judapies/Scrubber/2018/Artilab/Schematic/Scrubber V01.DXF

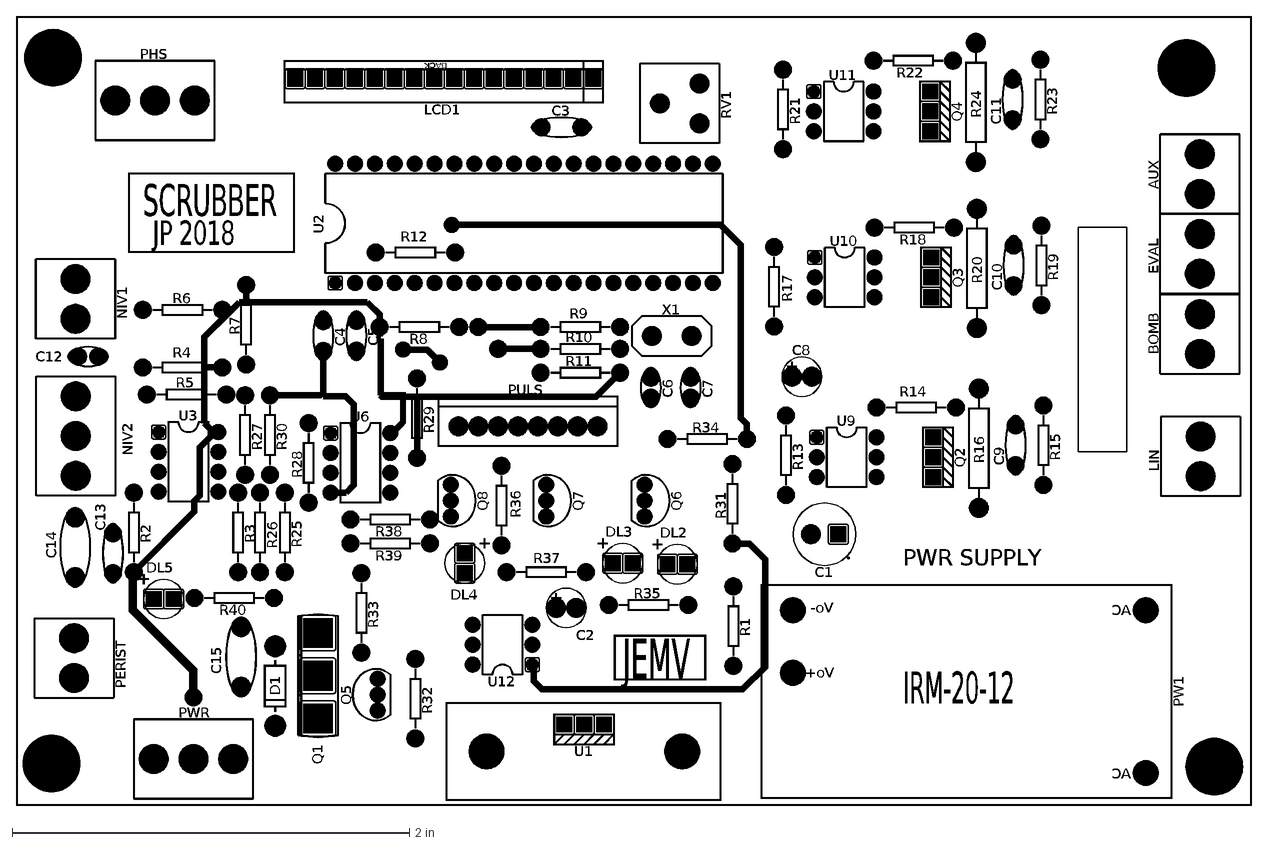
[picture p1: CAD file, 2021-07-30]
2018/Artilab/Schematic/Scrubber V01.DXF
U2
PHS
PULS
U9
Q2
BOMB
R13
R14
R16
C9
R15
U10
Q3
EVAL
R17
R18
R20
C10
R19
U11
Q4
AUX
R21
R22
R24
C11
R23
LIN
U3
U6
R12
PERIST
U12
Q5
Q1
R32
U1
C1
C2
AC
Vo+
Vo-
PW1
NIV2
RV1
BACK
LCD1
R8
R9
R10
R11
C4
C5
C3
C8
X1
C6
C7
R31
R1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
