judapies/Scrubber/2019/Bioweb/Schematic/Scrubber V01.DXF

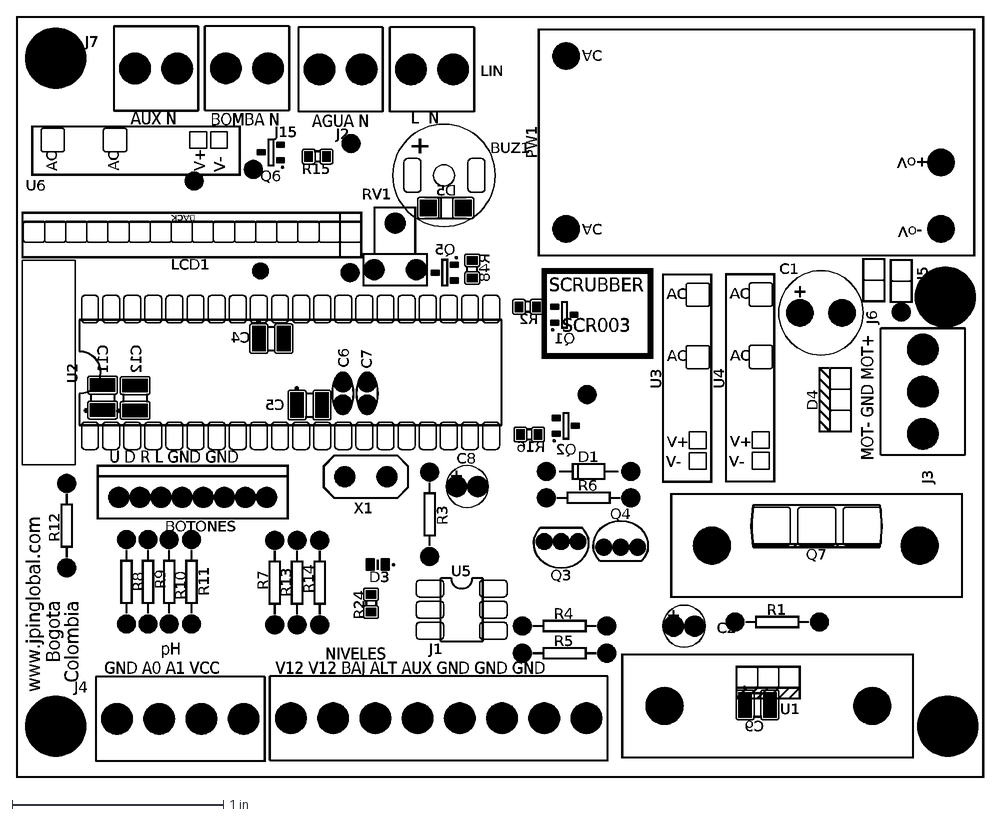
[picture p2: CAD file, 2021-07-30]
2019/Bioweb/Schematic/Scrubber V01.DXF
U1
AC
Vo+
Vo-
PW1
U2
R12
C12
C11
J4
R8
R9
R10
R11
R7
R13
R14
J1
BOTONES
R3
U5
X1
C6
C7
R4
R5
Q3
Q4
R6
D1
Q7
R16
Q2
V+
V-
U3
R2
Q1
U4
BACK
LCD1
J15
J3
J2
LIN
D4
R48
Q5
R24
D3
+
BUZ1
D5
R1
C4
C5
C8
C9
C1
C2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
