judapies/Scrubber/(list of files, cad)

Other CAD files:
2018/Artilab/Plano Electrico/Plano Electrico Scrubber/ConexionesElectricasYElectronicas.dwg
2019/Bioweb/Plano Electrico/Plano Electrico Scrubber/ConexionesElectricasYElectronicas.dwg
2021/Bioweb/Plano Electrico/Plano Electrico Scrubber/ConexionesElectricasYElectronicas.dwg
Plano Electrico/Mini-Cabina 110VAC/Distribucion de conexiones.dwg
Plano Electrico/Plano_Electrico_Cabina_Flujo_Vertical/Distribución de Conexiones.dwg
Plano Electrico/Plano_Electrico_Cabina_Flujo_Vertical/Conexiones de Luz Germicida y Luz Blanca.dwg
Plano Electrico/Plano_Electrico_Cabina_Flujo_Vertical/Conexiones de Panel de Control.dwg
Plano Electrico/Plano_Electrico_Cabina_Flujo_Vertical/Cabina_Flujo_Laminar_Vertical_JPCV36.dwg
