judapies/Scrubber/2018/Artilab/Plano Electrico/PlanoScrubberJEMV.pdf

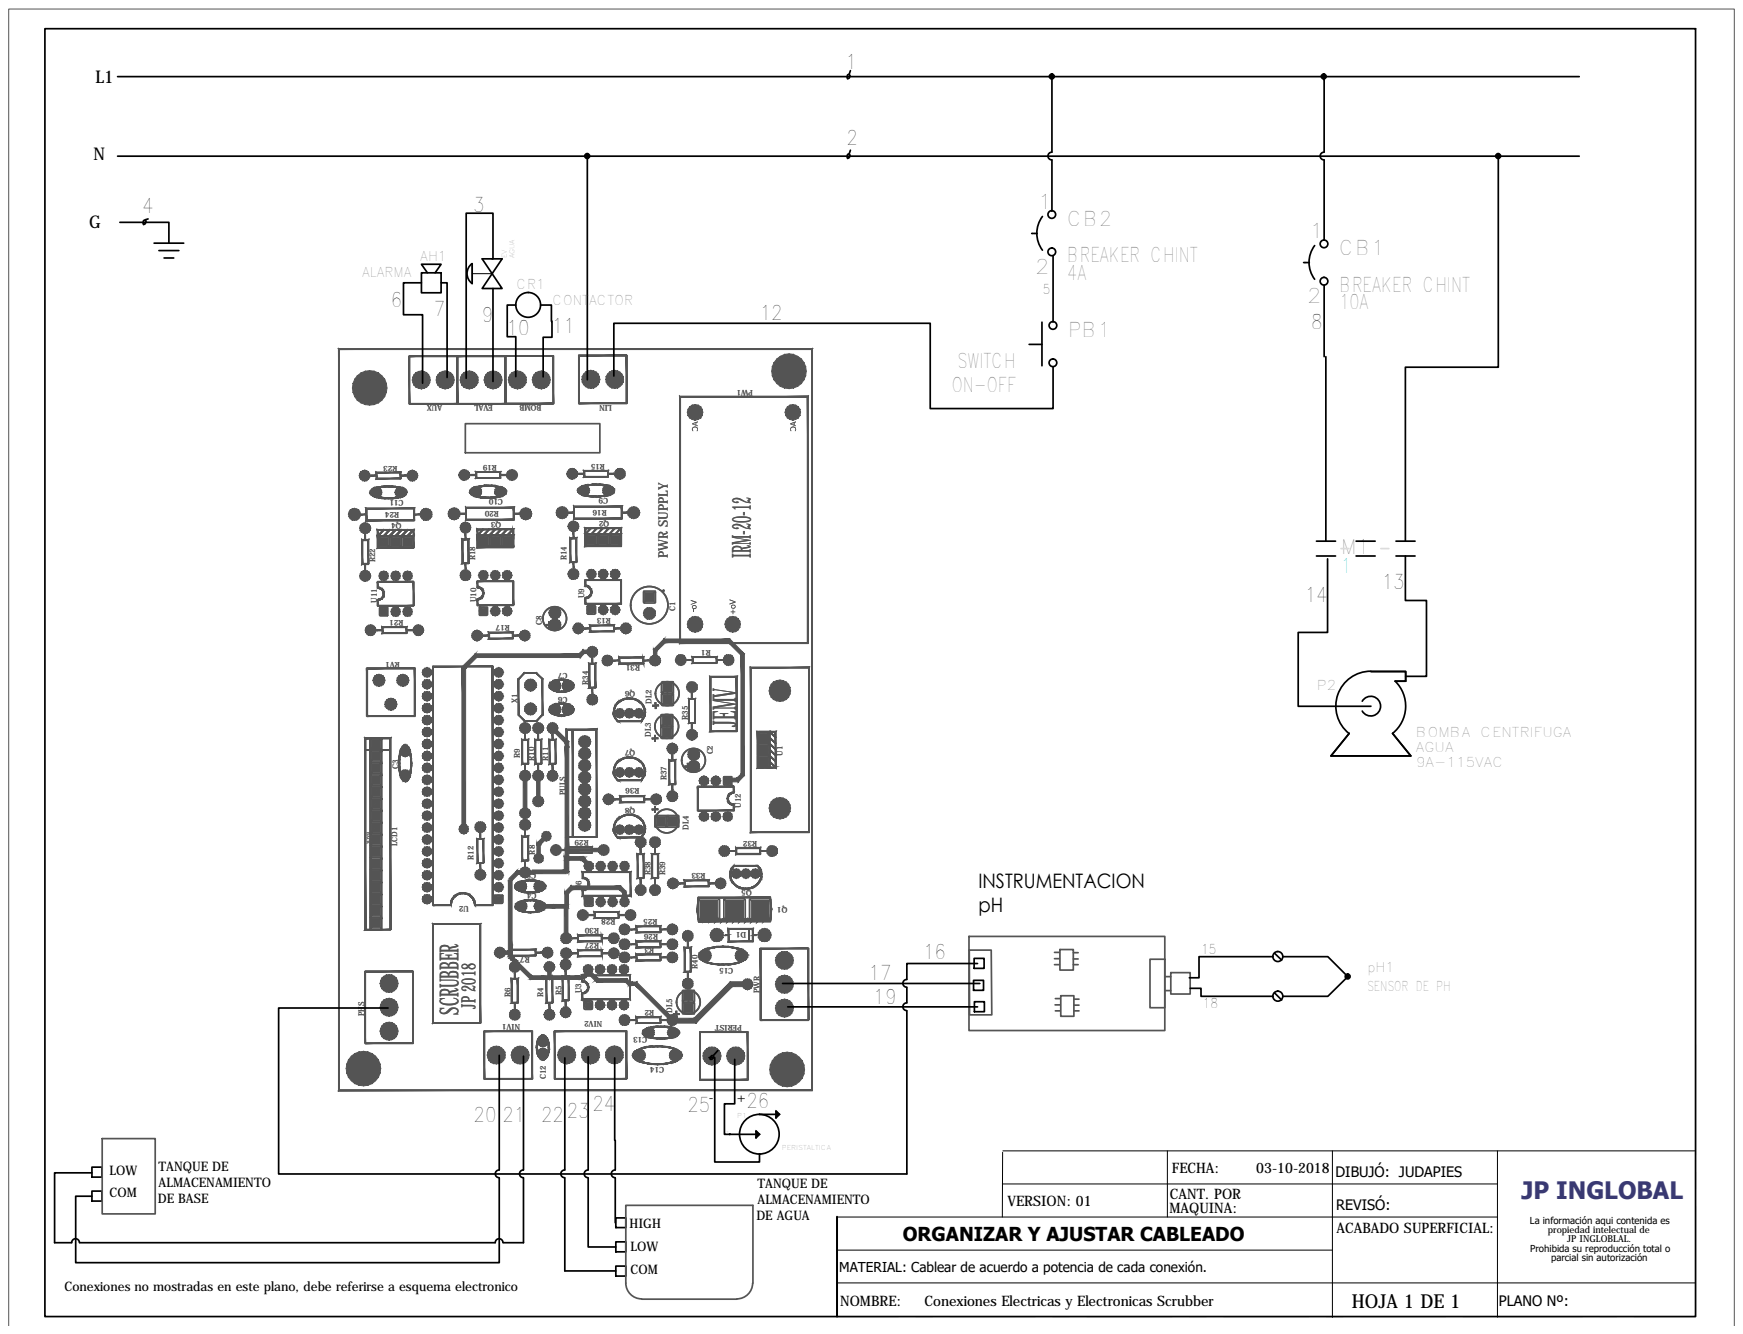
[picture p19: page 1]

AGUA ALARMA AH1 CONTACTOR CR1 BOMBA CENTRIFUGA AGUA 9A-115VAC P2 INSTRUMENTACION pH SENSOR DE PH pH1 3 5 8 9 14 1719 20 21 23 12 10 11 7 6 13 LOW COM 22 24 25 26 16 18 15

PWR D1 ON-OFF SWITCH PB1 4ABREAKER CHINT CB2 21 TANQUE DE ALMACENAMIENTO DE AGUA HIGH LOW COM TANQUE DE ALMACENAMIENTO DE BASE PERISTALTICA + - P1 - +
