judapies/Scrubber/2019/Bioweb/Plano Electrico/PlanoScrubber.pdf

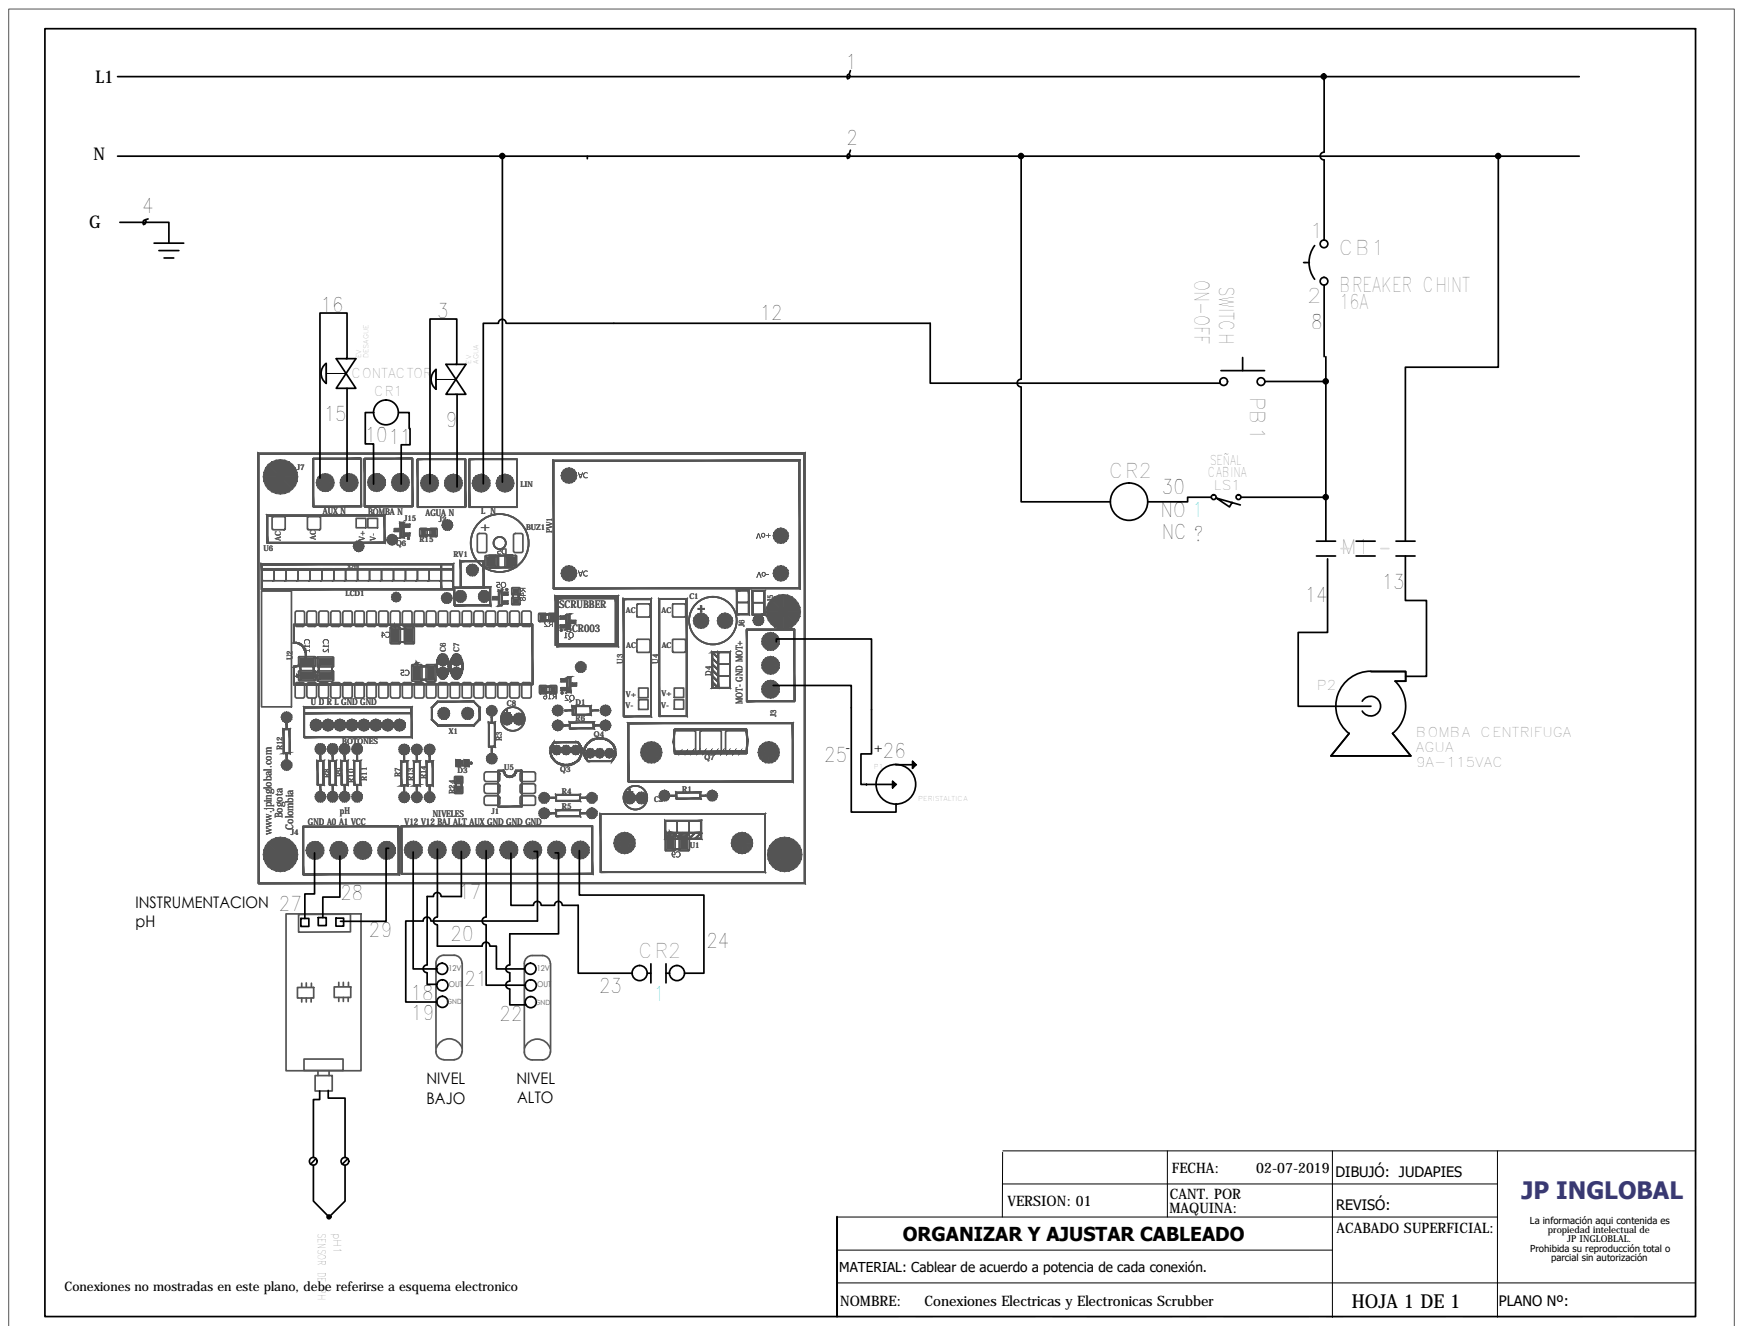
[picture p20: page 1]

J6 GND A0 A1 VCC pH V12 V12 BAJ ALT AUX GND GND GND NIVELES U D R L GND GND MOT- GND MOT+ BOMBA N AGUA N L N

pH1 PERISTALTICA + - P1 25- +26 12V GND OUT 12V GND OUT NIVEL BAJO NIVEL ALTO 1918 22 21 2017 23 24
