judapies/Scrubber/Plano Electrico/PDF/Distribución de Conexiones-Presentación1.pdf

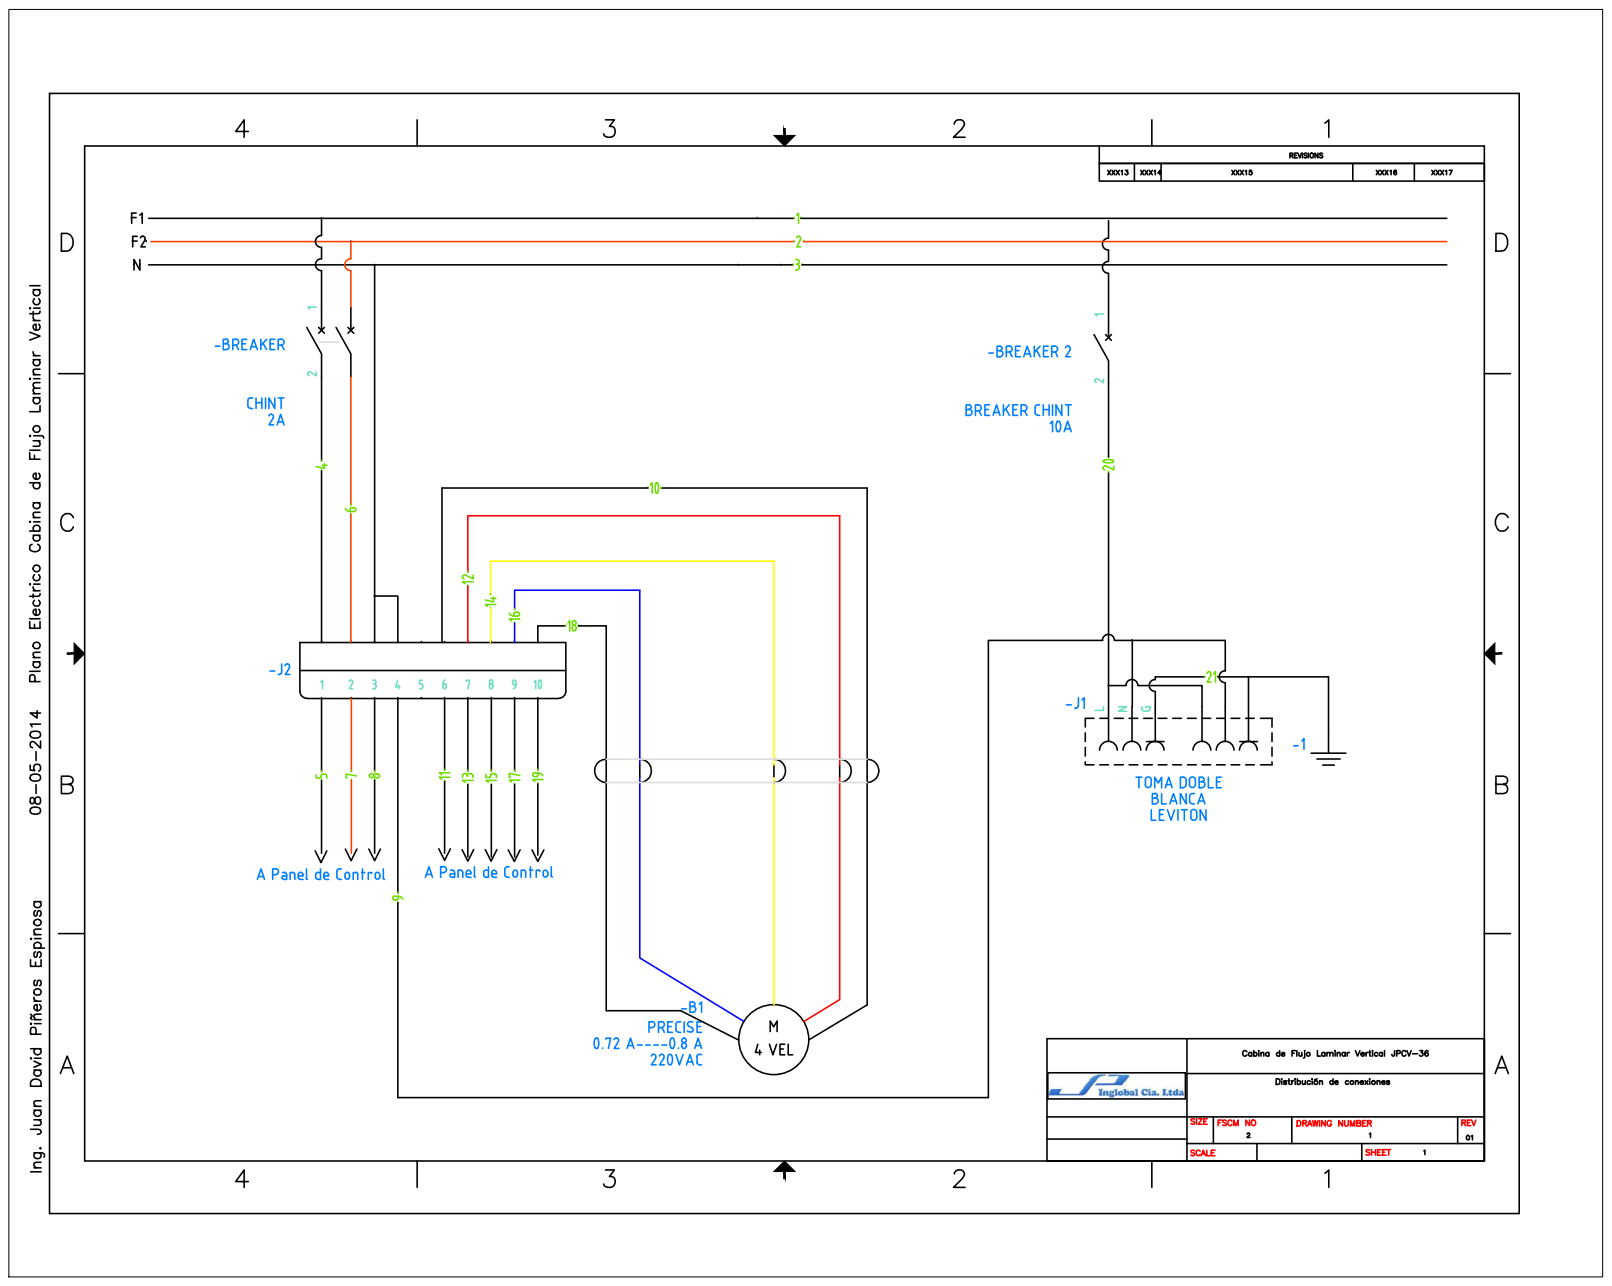
[picture p22: page 1]
