judapies/Scrubber/(list of files, drawings)

Other design files:
2018/Artilab/Schematic V2/Scrubber V02.pdsprj
2018/Artilab/Schematic/Scrubber V01.pdsprj
2018/Artilab/Schematic/Scrubber.DSN
2019/Bioweb/Schematic/Scrubber V01.pdsprj
2019/Bioweb/Schematic/Scrubber.DSN
2019/Bioweb/Scrubber V02.pdsprj
2021/Bioweb/Schematic/Scrubber V01.pdsprj
2021/Bioweb/Schematic/Scrubber.DSN
2021/Bioweb/Scrubber V02.pdsprj
Schematic/Scrubber.DSN
Schematic/Scrubber.LYT
